airs0urce/arduino_bicycle_turn_signals/schematics.jpg

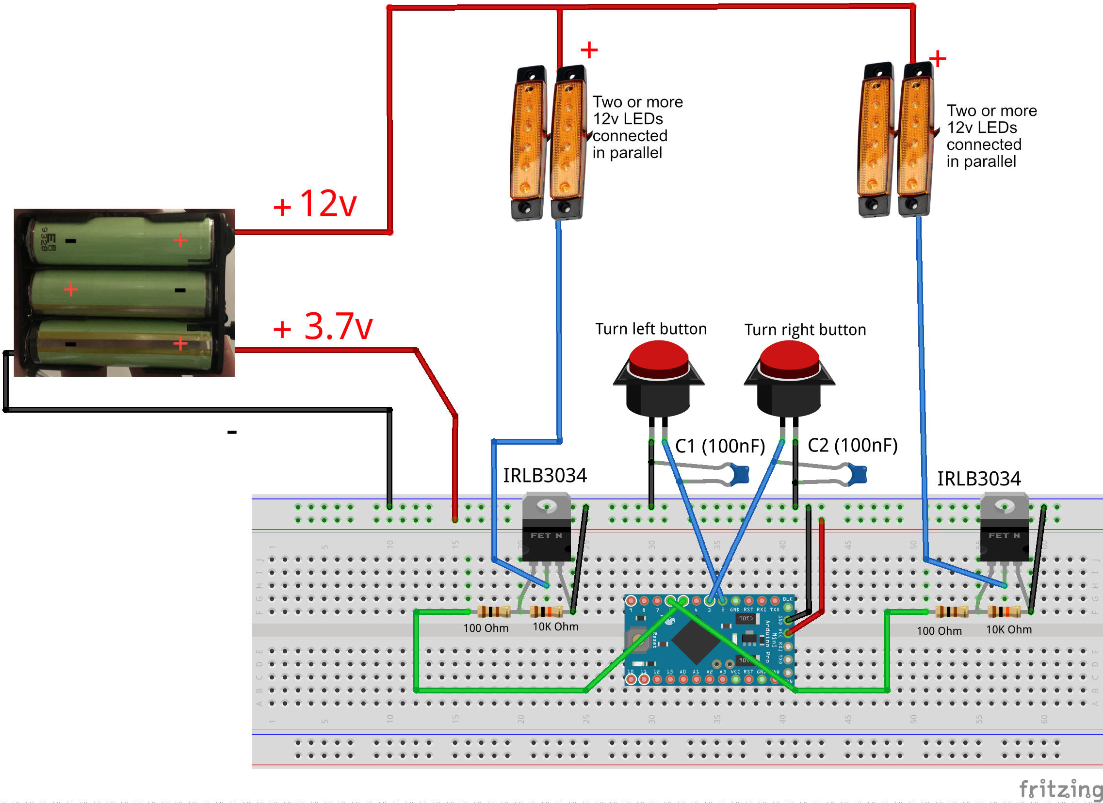
schematics.jpg
