airs0urce/arduino_bicycle_turn_signals/(commit log)

2020-11-12 handle edge case and small other changes
2020-11-29 added debounce capacitors for buttons
2020-12-06 added debounxe delay even for case when capacitor installed
2021-02-20 Revert "changes"
    This reverts commit 3bab7c60c44305e9849773ba963e72a573e4b55a.
    [BicycleTurnSignals.ino]
